jcorcoran/jjrc_xinput_controller/images/JJRC_LCD_all_segments_lit.jpg

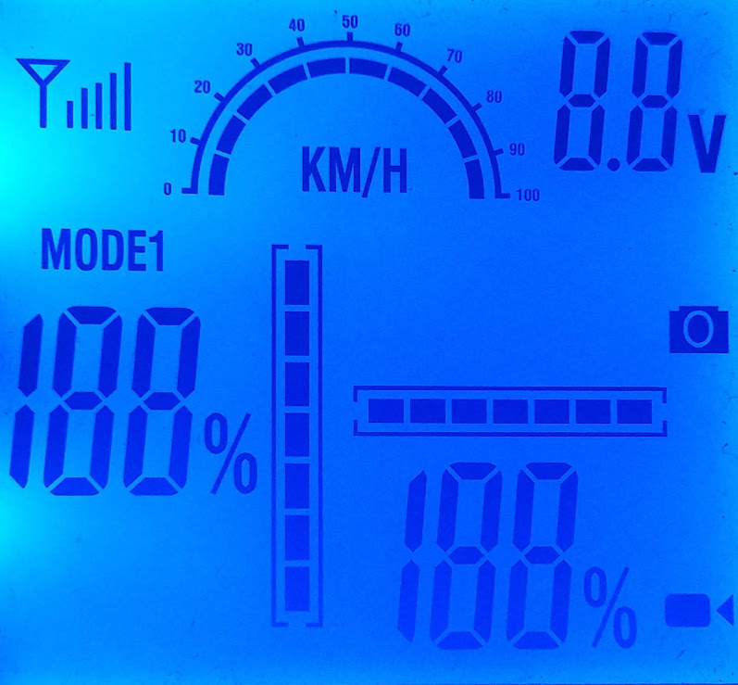
images/JJRC_LCD_all_segments_lit.jpg
