jcorcoran/jjrc_xinput_controller/(threads)

Thread 1 (2018-12-16):

Create function to drive 7 segment sections

jcorcoran, 2018-12-16:
Create a function that lets a numeric value be displayed to each of the three seven segment sections on the LCD.
X Axis 0-100%
Y Axis 0-100%
Voltage 0 - 99 V (also has a decimal point for values 0.1 - 9,9)

jcorcoran, 2018-12-31:
closed by https://github.com/jcorcoran/jjrc_xinput_controller/commit/78096c91ec4472a66b4cb0c9fca3ba4464205525

Closed 2018-12-31.

Thread 2 (2018-12-16):

Function to drive the gauges

jcorcoran, 2018-12-16:
Add a function that will let the different gauges be driven.

- KM/H
- X Axis
- Y Axis

jcorcoran, 2018-12-17:
Added in 6ca8fad43668695974b79ba9815ebe0cf38d1c8c

Closed 2018-12-17.

Thread 3 (2018-12-16):

Add Calibration Routine

jcorcoran, 2018-12-16:
Add feature which will allow calibration of the X and Y axis

- This should be entered during startup if a specific button is pressed?
- Once in the cal mode, X and Y axis can be moved through full range of travel.
- Read out of current position in cal mode.
- Press and hold button to save calibration data to EEPROM
- Restart and run in normal mode

Beep while in calibration mode?

jcorcoran, 2018-12-31:
resolved in https://github.com/jcorcoran/jjrc_xinput_controller/commit/61043ad8e2525118186447cb966f9af9f1e7acbd

Closed 2018-12-31.

Thread 7 (2018-12-31):

Investigate LED control

jcorcoran, 2018-12-31:
xinput library supports controlling LED on the joystick ([XINPUT::LEDPatternSelect](https://github.com/zlittell/MSF-XINPUT/blob/master/MSF_XINPUT/xinput.cpp)). Looks like it works, as LEDs flashed on main PCB when plugged into computer w/ driver station running.

Investigate how this can be controlled from the robot/driver station, maybe through the rumble commands from the DS if the LED controls aren't exposed through the DS class?
