jcorcoran/jjrc_xinput_controller/(commit log)

2018-11-24 Initial commit
    Buttons, rumble, and sticks tested working on Teensy 3.5
2018-11-24 Update jjrc_xinput_controller.ino
    Fix/add comments
    [jjrc_xinput_controller.ino]
2018-11-24 Add circuit diagram for motor control
2018-11-26 Update README.md
    Added links and pictures.
    Fleshed out some of the install steps.
    Added some explanation of how the PWM outputs work to drive the rumble motors.
    Added section describing LCD interface.
2018-12-17 Finish defining segments
    Also cleaned up old debug print statements
2018-12-27 Moved LCD class under the arduino projects src directory.
2018-12-27 Moved segment definitions under the LCD class. Added support for use of seven segment library and tested working on LCD.
    In this commit, X and Y count up in decimal, volts count up in hex.
    Decimal point support not added yet.
2018-12-28 Revised lower case "c" and "e" values, as they look goofy on the LCD.
2018-12-28 Added beginnings of a calibration mode. Still need to add functions to read/write eeprom, but otherwise working.
2018-12-31 Tested working on the Teensy LC.
    Added and tested code to read buttons off analog input channel.
    Moved vibration motor pins as these were conflicting with serial channels 2 & 3 pins. Originally intended for them to be on A8 and A9, but misunderstood that the AnalogWrite function takes a pin number and not the analog channel number (like AnalogRead).
    [jjrc_xinput_controller.ino]
2018-12-31 Added code to read/write to the eeprom.
    Modified calibration related functions to use the buttons on analog inputs instead of the discrete ones that were prototyped with.
    Added ability to exit calibration without saving by pressing and holding the left menu button.
2018-12-31 Added joystick scaling using stored calibration data.
2019-01-02 Update README.md
    Added more links, wiring information, etc. to reflect what was done rather than what was planned.
